pengyi05/stm32-music-box/Hardware/BOM.csv

# 硬件物料清单（BOM）
> 面试时如果被问"成本多少"或"选型依据"，这张表能直接回答。
> 标注「待确认」的项需要对照 PCB 实际采购记录补全。
## 主控与核心
 | 位号 | 器件 | 型号 | 数量 | 说明
 | --- | --- | --- | --- | ---
 | U1 | 主控芯片 | AT89C52 | 1 | 8051 架构 8 位单片机，DIP40，11.0592MHz
 | U2 | 稳压芯片 | 7805（待确认） | 1 | 51 为 5V 供电；也可能是 AMS1117-5.0
## 音频输出
 | 位号 | 器件 | 型号 | 数量 | 说明
 | --- | --- | --- | --- | ---
 | LS1 | 无源蜂鸣器 | 待确认 | 1 | 由 P1.0 经三极管驱动，必须是无源蜂鸣器
 | Q1 | NPN 三极管 | 8050 / 9013（待确认） | 1 | 蜂鸣器驱动，基极串限流电阻
 | R1 | 基极限流电阻 | 1KΩ | 1 | 保护 MCU 引脚，防止过流
## 显示
 | 位号 | 器件 | 型号 | 数量 | 说明
 | --- | --- | --- | --- | ---
 | DS1 | 8×8 点阵模块 | 共阳/共阴待确认 | 1 | P0 列选 + P2 行选
 | R2-R9 | P0 上拉电阻 | 10KΩ | 8 | **P0 为开漏输出，必须外接上拉，否则点阵不亮**
 | D1-D7 | LED | 待确认 | 7 | P1.1~P1.7，音高分区指示
 | R10-R16 | LED 限流电阻 | 1KΩ（待确认） | 7
## 输入
 | 位号 | 器件 | 型号 | 数量 | 说明
 | --- | --- | --- | --- | ---
 | SW1-SW3 | 轻触按键 | 待确认 | 3 | 播放/暂停、下一曲、上一曲，低电平有效
 | SW4 | 拨动开关 | 待确认 | 1 | P3.7，单曲循环 / 列表循环
 | R17-R20 | 上拉电阻 | 10KΩ | 4 | 按键与开关的默认电平
## 时钟与复位
 | 位号 | 器件 | 型号 | 数量 | 说明
 | --- | --- | --- | --- | ---
 | X1 | 晶振 | 11.0592MHz | 1 | **必须 11.0592MHz**，串口通信与定时器精度都依赖它
 | C1, C2 | 晶振负载电容 | 22pF（待确认） | 2
 | C3 | 复位电容 | 10uF | 1 | 上电复位
 | R21 | 复位上拉电阻 | 10KΩ | 1
 | SW5 | 复位按键 | 待确认 | 1
 | — | BOOT 跳帽 | 2.54mm 排针 | 1 | 切换 ISP 下载（未使用）
## 供电与去耦
 | 位号 | 器件 | 型号 | 数量 | 说明
 | --- | --- | --- | --- | ---
 | J1 | 电源接口 | DC 插座 / 排针（待确认） | 1 | 5V 输入
 | C4-C8 | 去耦电容 | 100nF | 5 | 每个电源引脚旁各一个，高频去耦
 | C9 | 储能电容 | 10uF | 1 | 低频去耦，靠近稳压芯片输出
 | LED | 电源指示灯 | 5mm（待确认） | 1 | 串联限流电阻
## 调试与接口
 | 位号 | 器件 | 型号 | 数量 | 说明
 | --- | --- | --- | --- | ---
 | — | 下载接口 | 排针（待确认） | 1 | 51 用 ISP 串行下载，无专用调试器
 | — | 串口接口 | 3pin 排针（待确认） | 1 | 接 USB-TTL 模块下载与调试输出
 | — | 排针 | 2.54mm | 若干 | 各 IO 口引出，便于调试
---
## 成本汇总
 | 项目 | 金额
 | --- | ---
 | 元器件总价 | ¥ 待确认
 | PCB 打板 | ¥ 待确认
 | 焊接 / 手工 | ¥ 待确认
 | **总计** | **¥ 待确认**
> 这个数字面试时可能被问到（"这个方案成本多少，量产可行吗"）。
> 补全时请对照实际采购记录，估算值不如真实值有说服力。
---
## 选型依据说明（面试可讲）
 | 器件 | 为什么这么选
 | --- | ---
 | AT89C52 | 8KB Flash 足够放下三首曲目的乐谱表；128B RAM 够用；51 生态成熟、资料多，适合作为第一个完整项目
 | 11.0592MHz 晶振 | 该频率经 12 分频后每机器周期 ≈1.085μs，且 UART 波特率无需误差修正，定时器与串口都能精确
 | 无源蜂鸣器 | 有源蜂鸣器只能发固定音高，无法演奏旋律；无源蜂鸣器由外部方波驱动频率，才可能播放多首曲子
 | P0 外接 10K 上拉 | 8051 的 P0 是开漏输出，内部无上拉，不加外部上拉无法输出高电平
 | 贴片焊接 | 手工焊接 0805 电阻电容比 DIP 更快，且贴片件体积小，PCB 尺寸与重量都更优
