pengyi05/stm32-music-box/(list of files, drawings)

Other design files:
Hardware/SCH/新工程.pdsprj
