pengyi05/stm32-music-box/Firmware/User/delay.h

/*
 * ============================================================================
 *  delay.h —— 毫秒延时模块接口声明
 * ============================================================================
 *
 *  【头文件保护】
 *  #ifndef / #define / #endif 构成"包含保护"，防止同一头文件被重复包含。
 *  若无保护，当多个 .c 文件都 #include "delay.h" 时，
 *  函数会被重复声明，可能导致编译错误或代码膨胀。
 *  守卫宏名通常与文件名一致（本例为 __DELAY_H__），避免与其他文件冲突。
 *
 *  ============================================================================
 */

#ifndef __DELAY_H__
#define __DELAY_H__

/* 阻塞式毫秒延时，具体实现见 delay.c */
void DelayMs(unsigned int ms);

#endif /* __DELAY_H__ */
