pengyi05/stm32-music-box/Firmware/User/key.h

/*
 * ============================================================================
 *  key.h —— 【早期版本，当前工程未引用】按键扫描模块接口声明
 * ============================================================================
 *
 *  Keil 工程 atm89.uvproj 未引用 key.c，本头文件仅作开发留档。
 *  最终版的按键处理直接写在 main.c 中，无需独立头文件。
 *
 *  ============================================================================
 */

#ifndef __KEY_H__
#define __KEY_H__

/* 按键扫描函数，具体实现见 key.c */
void Key_Scan(void);

#endif /* __KEY_H__ */
