pengyi05/stm32-music-box/Firmware/User/led.c

/*
 * ============================================================================
 *  led.c —— 【早期版本，当前工程未引用】
 * ============================================================================
 *
 *  本文件是项目早期的 LED 驱动模块，Keil 工程 atm89.uvproj 未引用本文件。
 *  最终实现见 main.c 中的 init_leds() 与 update_led_by_note()。
 *
 *  【与最终版的差异】
 *      本文件 led.c ：P2 口 8 位跑马灯，仅用于硬件连通性验证
 *      main.c      ：P1 口 bit1~bit7 作为音高指示，
 *                    开机自检时运行一次跑马灯，播放时指示当前音高
 *
 *  【设计演进说明】
 *    早期用跑马灯是为了验证 LED 是否全部焊接良好 —— 这是纯硬件测试逻辑。
 *    最终版保留了该自检功能（init_leds），但把播放时的 LED 用途
 *    改为"音高可视化"：7 个 LED 分别对应 7 个音区，播放时点亮当前
 *    音高对应的 LED，使音高变化肉眼可见。这比单纯跑马灯更有信息量。
 *
 *  ============================================================================
 */

#include <REGX52.H>

/* 当前流水灯位置（0~7） */
unsigned char pos = 0;

/* ===========================================================================
 *  LED_Init —— LED 端口初始化
 * ===========================================================================
 *
 *  设置 P2 口全部输出为高电平。
 *  对于共阳极接法的 LED，输出高电平即为熄灭（不点亮）。
 */
void LED_Init()
{
    P2 = 0xFF;
}

/* ===========================================================================
 *  LED_Flow —— 流水灯
 * ===========================================================================
 *
 *  每次调用点亮一位 LED，并将位置指针循环移动。
 *  被主循环反复调用即可形成流水灯效果。
 *
 *  【位运算说明】
 *    P2 = ~(1 << pos) 的作用：
 *      1 << pos 生成只有第 pos 位为 1 的掩码；
 *      取反后变为"只有第 pos 位为 0，其余位为 1"；
 *      赋给 P2 即实现"仅点亮第 pos 位的 LED"（共阳极接法下输出低电平点亮）。
 *
 *    pos = (pos+1) % 8 实现指针在 0~7 之间循环，不会越界。
 */
void LED_Flow()
{
    P2 = ~(1 << pos);       /* 点亮当前位 */
    pos = (pos + 1) % 8;    /* 移动到下一位，循环 */
}
