pengyi05/stm32-music-box/Firmware/User/led.h

/*
 * ============================================================================
 *  led.h —— 【早期版本，当前工程未引用】LED 模块接口声明
 * ============================================================================
 *
 *  Keil 工程 atm89.uvproj 未引用 led.c，本头文件仅作开发留档。
 *  最终版的 LED 功能写在 main.c 的 init_leds() 与 update_led_by_note() 中。
 *
 *  ============================================================================
 */

#ifndef __LED_H__
#define __LED_H__

/* LED 端口初始化 */
void LED_Init(void);

/* 流水灯 */
void LED_Flow(void);

#endif /* __LED_H__ */
