pengyi05/stm32-music-box/Firmware/User/matrix.c

/*
 * ============================================================================
 *  matrix.c —— 【早期版本，当前工程未引用】
 * ============================================================================
 *
 *  本文件是项目早期的点阵显示模块，Keil 工程 atm89.uvproj 未引用本文件。
 *  完整实现见 main.c 中的 Display_Num()。
 *
 *  【当前状态说明】
 *  本文件的 Matrix_ShowNumber() 函数体仅有一行 P0=0x00，
 *  是一个尚未完成的空壳 —— 早期版本中此模块未被真正实现，
 *  实际的点阵动态扫描逻辑最终写在 main.c 中。
 *
 *  【为什么保留此文件】
 *  记录开发过程中"先规划模块、后逐个实现"的过程痕迹。
 *
 *  ============================================================================
 */

#include <REGX52.H>

/* ===========================================================================
 *  Matrix_ShowNumber —— 在 8x8 点阵上显示数字（未完成）
 * ===========================================================================
 *
 *  参数 num —— 要显示的数字
 *
 *  【最终版实现要点】（见 main.c 的 Display_Num 函数）
 *    本函数原计划使用矩阵键盘扫描的方式实现，思路是：
 *      1) 取出 num 对应的点模数组（LED_Num1/2/3）
 *      2) 逐行扫描：行端输出该行点模，列端选通对应位
 *      3) 每行延时 2ms，保证人眼可分辨
 *      4) 8 行循环完成一帧
 *
 *    但由于此方式与按键扫描共用 P0 口，会与矩阵键盘冲突，
 *    最终版改为将点阵显示逻辑直接内联到 main.c，
 *    并在按键处理逻辑上做了调整。
 *
 *  【本函数的现状】
 *    仅清空 P0 口（P0=0x00），关闭所有列选通，不显示任何内容。
 *    8051 的 P0 口为开漏输出，使用前必须外接上拉电阻（通常为 4.7k~10k）。
 *
 */
void Matrix_ShowNumber(unsigned char num)
{
    /* 仅实现端口清零，实际显示逻辑见 main.c 的 Display_Num() */
    P0 = 0x00;
}
