pengyi05/stm32-music-box/Firmware/User/matrix.h

/*
 * ============================================================================
 *  matrix.h —— 【早期版本，当前工程未引用】点阵显示模块接口声明
 * ============================================================================
 *
 *  Keil 工程 atm89.uvproj 未引用 matrix.c，本头文件仅作开发留档。
 *  最终版的点阵显示实现在 main.c 的 Display_Num() 中。
 *
 * ============================================================================
 */

#ifndef __MATRIX_H__
#define __MATRIX_H__

/* 在8x8 点阵上显示数字（早期版本未完成） */
void Matrix_ShowNumber(unsigned char num);

#endif /* __MATRIX_H__ */
