pengyi05/stm32-music-box/Firmware/User/music.h

/*
 * ============================================================================
 *  music.h —— 【早期版本，当前工程未引用】音乐播放模块接口声明
 * ============================================================================
 *
 *  Keil 工程 atm89.uvproj 未引用 music.c，本头文件仅作开发留档。
 *  最终版的音乐播放实现在 main.c 中，采用定时器中断驱动方式。
 *
 *  ============================================================================
 */

#ifndef __MUSIC_H__
#define __MUSIC_H__

/* 当前曲目编号，由 key.c 修改 */
extern unsigned char song_id;

/* 播放下一个音符 */
void Play_Music(void);

#endif /* __MUSIC_H__ */
