pengyi05/stm32-music-box/(commit log)

2026-10-14 Initial commit: AT89C52 music box project
    [BOM.csv, 新工程.pdsprj]
2026-10-14 refactor:add comprehensive Chinese comment and fix sizeof bug
    [delay.c, delay.h, key.c, key.h, led.c, led.h, main.c, matrix.c]
2026-10-20 docs: rewrite README/BOM/debug log to match actual AT89C52 project
    - README: remove AI template residue (STM32F103, periph.c, stm32f10x lib,
    placeholder text); rewrite with real architecture, real gequ table-driven
    design, dual-timer split, 8051 code keyword, real pin assignment
    - BOM: replace STM32F103/8MHz with AT89C52/11.0592MHz and real peripheral
    list; add selection rationale table
    - debug log: fill in 7 real debugging cases (P0 open-drain pull-up, buzzer
    current limit, sizeof array boundary, code keyword RAM overflow, 8051
    12-division timing, ISR length, Keil relative path)
    [BOM.csv]
2026-10-21 docs: add STM32F411 debugging cases (problems 8-12) to debug log
    - problem 8: CubeIDE 'No ST-LINK detected' was actually a misleading error;
    root cause was missing PC13 config in .ioc failing project validation
    - problem 9: debuggers halt the CPU, so 'program not running' after flashing
    was not a code bug; fixed by clicking Run or disconnecting
    - problem 10: F411 has no BRR register (F1 does); F4 merged it into BSRR high 16 bits
    - problem 11: forgot GPIOC clock enable; peripherals are unpowered by default
    - problem 12: two while(1) loops in main locked out UART init
    Also split the pitfall cheat sheet into 8051 and STM32 sections.
